ajaisehgal/esp-dsc/pics/SettingCirclesPCB.pdf

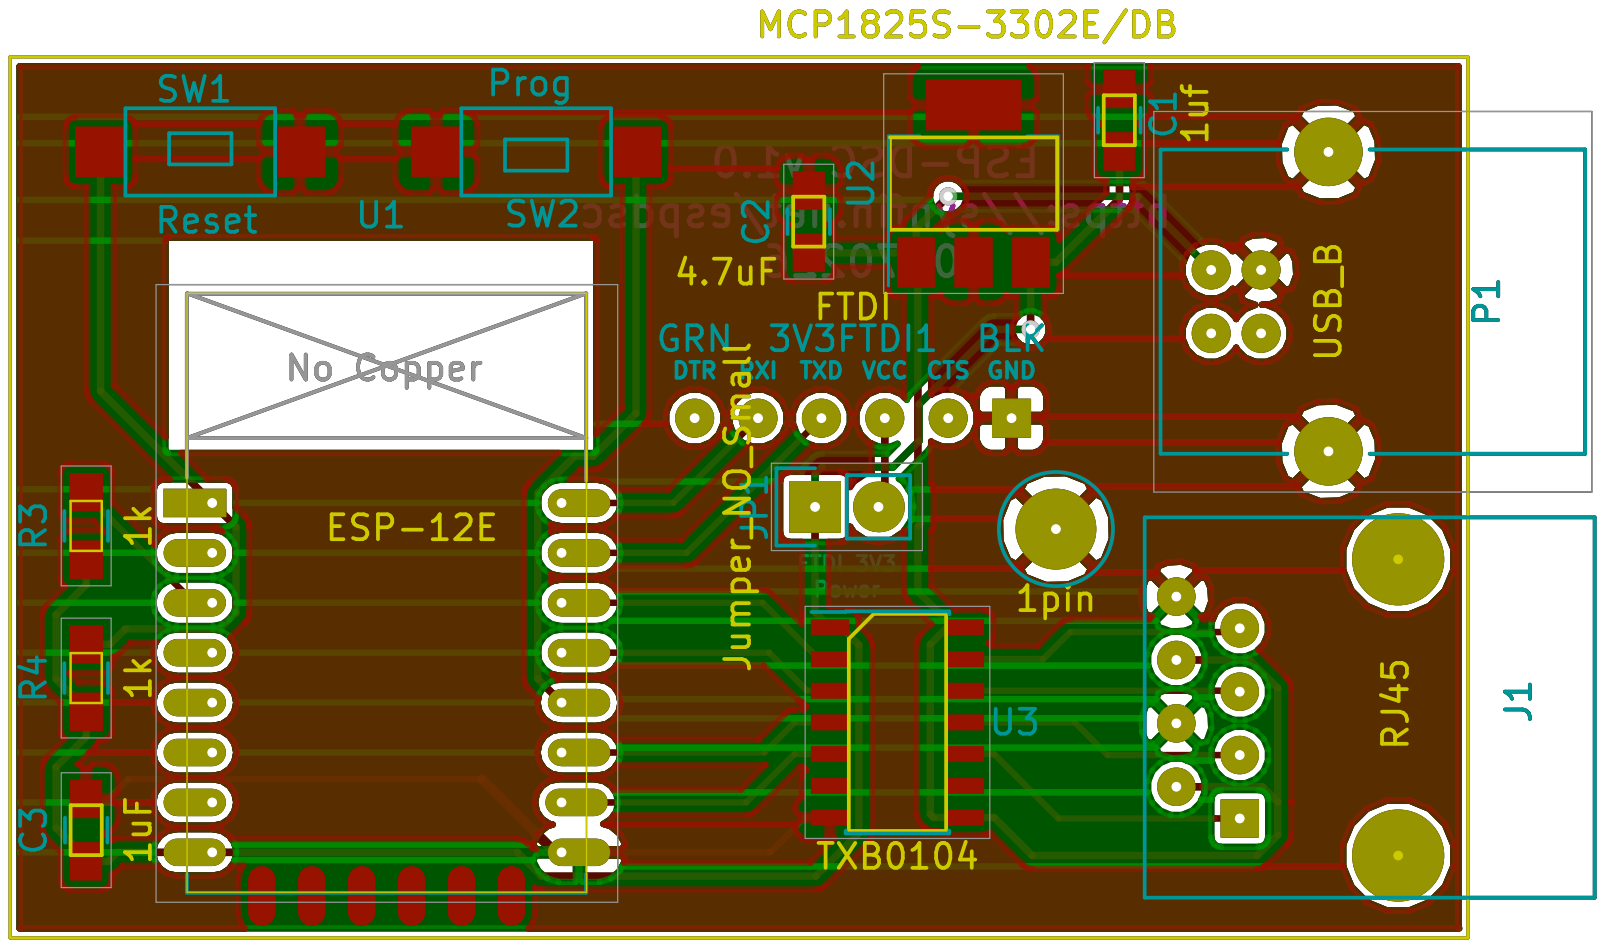
[picture p1: page 1]
