ajaisehgal/esp-dsc/(commit log)

2017-07-30 Documentation Clarifications
    Added the NodeMCU pins to use and clarfied the need to have the Encoder lib in the Arduino Library directory.
2017-07-30 Added paths to Encoder library
    There is a fixed version of the encoder library for the ESP8266.
2017-07-31 Pin outs pictures
    Pics of pinouts for old E12 and NodeMCU V1 / V2 along with the PCB for
    the old E12.
2017-08-11 Change use of D8 to D5
    D8 is on the NodeMCU is used for boot, flashing and programming. If used for an input, none of the above works correctly. Switched it to D5.
    [esp_dsc.ino]
2017-08-11 Use internal pull up
    Got rid of the need to use external 10K pull-up resistors by setting D1, D2, D4 and D5 to INPUT_PULLUP.
2017-08-12 Final version
    Moved off of D4 onto D6 as D4 causes issues
    [esp_dsc.ino]
